unaldevelopment/8-Channel-Wireless-EEG/eeg.kicad_pcb

## KiCad design eeg.kicad_pcb (2026-10-16)

Schematic: eeg.sch, EEG HEADSET

Parts:
C1: 1nF; C_0603_1608Metric
C2, C3, C4, C5, C6, C7, C8, C9, C10, C11, C12, C13, C14, C15, C16, C17, C18, C19: 4.7nF; C_0603_1608Metric
C20, C104, C105, C109, C110, C114, C115, C119, C120: 10uF; C_0603_1608Metric
C40, C48, C49, C50, C54, C58, C63, C66, C76, C77, C79, C106, C107, C108, C111, C112: 1uF; C_0603_1608Metric
C41, C52, C53, C56, C57, C59, C61, C64, C68, C70, C71, C72, C73, C74, C75, C78: 0.1uF; C_0603_1608Metric
C42: 4.7uF; C_0603_1608Metric
C51: 1.5nF; C_0805_2012Metric
C62, C69: 100uF; RESC3216X65N
C65: 10uF; RESC3216X65N
C67: 4.7uF; RESC3216X65N
C80, C81: 9pF; C_0603_1608Metric
C83: 0.1uF; CP_EIA-1608-08_AVX-J_Pad1.25x1.05mm_HandSolder
C100, C102: 1uF_X5R_0603; CAPC1608X94N
C101, C103: 100nF; CAPC1005X55N
C113, C116, C118: 2.2uF; C_0603_1608Metric
C117: 0.01uF; C_0603_1608Metric
D1, D2, D3, D4, D7: LED; LED_0603_1608Metric
HC7361: 2.048mhz; OSCCC500X320X150N
J1, J2, J3, J4: Conn_01x05_Male; PinHeader_1x05_P2.54mm_Vertical
J5: Conn_01x10; PinHeader_1x10_P1.27mm_Vertical
J6, J7: Conn_01x10_Male; PinSocket_1x10_P2.54mm_Vertical
J10: USB_B_Mini; USB_Micro-B_Molex_47346-0001
L1, L2, L4, L5: 3.3uH; INDC2012X87N
R1, R3, R5, R7, R9, R11, R13, R15, R17, R19: 4.99k; RESC1608X55N
R2, R4, R6, R8, R10, R12, R14, R16, R18: 4.99K; RESC1608X55N
R20, R21, R22, R32: 270; R_0603_1608Metric
R23: 10R
R24, R25: 4.7K
R26: 10K; R_0603_1608Metric
R27: 1M; RESC2012X60N
R28, R29: 10K; RESC1608X55N
R31: 270; R_0805_2012Metric
SW2: SW_DIP_x03; SW_DIP_SPSTx03_Slide_6.7x9.18mm_W6.73mm_P2.54mm_LowProfile_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
SW3: EVQ-Q2K03W
U1: STM32F446RE; LQFP-64_10x10mm_P0.5mm
U2: ADS1299-8; TQFP-64_10x10mm_P0.5mm
U3: LD39050PU33R; SON95P300X300X100-7N; DIGI-KEY_PART_NUMBER 497-8716-1-ND
U4: TPS60403DBVT; SOT95P280X145-5N
U5: TPS73225DBVT; SOT95P280X145-5N
U6: TPS72325DBVT; SOT95P280X145-5N
U12: RN4678-V_RM100; RM100
Y1: 16.00Mhz; Crystal_SMD_5032-4Pin_5.0x3.2mm

Connections:
+2V5: C40.1, C41.1, C49.1, C53.1, C115.1, J2.1, L5.2, U2.19 (AVDD), U2.21 (AVDD), U2.22 (AVDD), U2.54 (AVDD1), U2.56 (AVDD), U2.59 (AVDD)
+3V3: C20.2, C56.2, C57.1, C58.1, C59.2, C61.1, C64.2, C67.1, C71.1, C72.1, C73.1, C74.1, C75.2, C76.1, C77.1, C78.1, C79.1, C102.1, C103.1, HC7361.1 (EN), HC7361.4 (Vdd), J2.3, J4.1, J4.2, R28.2, R29.2, U1.1 (VBAT), U1.13 (VDDA/VREF+), U1.19 (VDD), U1.32 (VDD), U1.48 (VDD), U1.64 (VDD), U2.48 (DVDD), U2.50 (DVDD), U3.4 (VOUT), U12.4 (BAT_IN), U12.5 (SW_BTN)
+5V: C100.1, C101.1, C104.1, J3.1, J3.2, J3.3, J10.1 (VBUS), L1.1, U3.1 (EN), U3.6 (VIN)
-2V5: C48.2, C50.2, C52.2, C54.2, C62.2, C63.2, C65.2, C66.2, C68.1, C69.2, C70.2, C120.1, J2.2, L4.2, U2.20 (AVSS), U2.23 (AVSS), U2.25 (VREFN), U2.32 (AVSS), U2.53 (AVSS1), U2.57 (AVSS), U2.58 (AVSS)
-5V: C110.1, C116.1, L2.2, U6.2 (IN), U6.3 (EN)
/BIASIN: C1.1, C51.2, R1.2, R27.2, U2.62 (BIASIN), U2.63 (BIASOUT)
/BIASINV: C51.1, J7.1, R27.1, U2.61 (BIASINV)
/CBIAS: J7.2, R1.1
/CIN1N: J6.7, R16.1
/CIN1P: J6.8, R17.1
/CIN2N: J6.5, R14.1
/CIN2P: J6.6, R15.1
/CIN3N: J6.3, R12.1
/CIN3P: J6.4, R13.1
/CIN4N: J6.1, R10.1
/CIN4P: J6.2, R11.1
/CIN5N: J7.9, R8.1
/CIN5P: J7.10, R9.1
/CIN6N: J7.7, R6.1
/CIN6P: J7.8, R7.1
/CIN7N: J7.5, R4.1
/CIN7P: J7.6, R5.1
/CIN8N: J7.3, R2.1
/CIN8P: J7.4, R3.1
/CLK: HC7361.3 (OUT), J5.3, U2.37 (CLK)
/CSRB1: J6.9, R18.1
/CSRB2: J6.10, R19.1
/IN1N: C16.2, R16.2, U2.15 (IN1N)
/IN1P: C17.2, R17.2, U2.16 (IN1P)
/IN2N: C14.2, R14.2, U2.13 (IN2N)
/IN2P: C15.2, R15.2, U2.14 (IN2P)
/IN3N: C12.2, R12.2, U2.11 (IN3N)
/IN3P: C13.2, R13.2, U2.12 (IN3P)
/IN4N: C10.2, R10.2, U2.9 (IN4N)
/IN4P: C11.2, R11.2, U2.10 (IN4P)
/IN5N: C8.1, R8.2, U2.7 (IN5N)
/IN5P: C9.2, R9.2, U2.8 (IN5P)
/IN6N: C6.1, R6.2, U2.5 (IN6N)
/IN6P: C7.2, R7.2, U2.6 (IN6P)
/IN7N: C4.1, R4.2, U2.3 (IN7N)
/IN7P: C5.2, R5.2, U2.4 (IN7P)
/IN8N: C2.1, R2.2, U2.1 (IN8N)
/IN8P: C3.2, R3.2, U2.2 (IN8P)
/RN46CTS: U1.15 (PA1), U12.15 (P1_7/CTS)
/RN46RTS: U1.14 (PA0), U12.17 (P0_0/RTS)
/SRB1: C18.2, R18.2, U2.17 (SRB1)
/SRB2: C19.2, R19.2, U2.18 (SRB2)
/USART6_RX: U1.38 (PC7), U12.23 (TXD)
/USART6_TX: U1.37 (PC6), U12.22 (RXD)
/VCAP3: C50.1, C70.1, U2.55 (VCAP3)
CS: J5.7, U1.50 (PA15), U2.39 (CS)
DRDY: J5.9, U1.51 (PC10), U2.47 (DRDY)
MISO: J5.6, U1.56 (PB4), U2.43 (DOUT)
MOSI: J5.5, U1.57 (PB5), U2.34 (DIN)
unnamed: C42.1, U1.30 (VCAP_1)
unnamed: C54.1, U2.30 (VCAP2)
unnamed: C66.1, U2.26 (VCAP4)
unnamed: C69.1, U2.28 (VCAP1)
unnamed: C80.1, U1.6 (PH1-OSC_OUT), Y1.1
unnamed: C83.1, SW3.2, SW3.4, U1.7 (NRST)
unnamed: C105.1, C106.1, C111.1, L1.2, U4.2 (IN), U5.1 (IN), U5.3 (EN)
unnamed: C107.1, U4.5 (CFLY+)
unnamed: C107.2, U4.3 (CFLY-)
unnamed: C108.1, C109.1, L2.1, U4.1 (OUT)
unnamed: C112.1, U5.4 (NR)
unnamed: C113.1, C114.1, L5.1, U5.5 (OUT)
unnamed: C117.1, U6.4 (NR)
unnamed: C118.1, C119.1, L4.1, U6.5 (OUT)
unnamed: D1.2 (A), R32.2
unnamed: D2.1 (K), R20.1
unnamed: D2.2 (A), U1.27 (PB1)
unnamed: D3.1 (K), R21.1
unnamed: D3.2 (A), U1.26 (PB0)
unnamed: D4.1 (K), R22.1
unnamed: D4.2 (A), U1.25 (PC5)
unnamed: D7.1 (K), U12.30 (LED)
unnamed: D7.2 (A), R31.1
unnamed: R26.2, U1.60 (BOOT0)
unnamed: R23.1, R31.2, U12.6 (LDO33_O), U12.7 (VDD_IO), U12.9 (WAKEUP)
unnamed: R32.1, U2.42 (GPIO1)
PWDN: J5.1, R28.1, U1.61 (PB8), U2.35 (PWDN)
RESET: J5.2, R29.1, U1.59 (PB7), U2.36 (RESET)
SCLK: J5.8, U1.55 (PB3), U2.40 (SCLK)
START: J5.4, U1.58 (PB6), U2.38 (START)
SWCLK: J4.4, U1.49 (PA14)
SWDIO: J4.3, U1.46 (PA13)
VREFP: C65.1, C68.2, J1.3, J1.4, J1.5, U2.24 (VREFP)

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
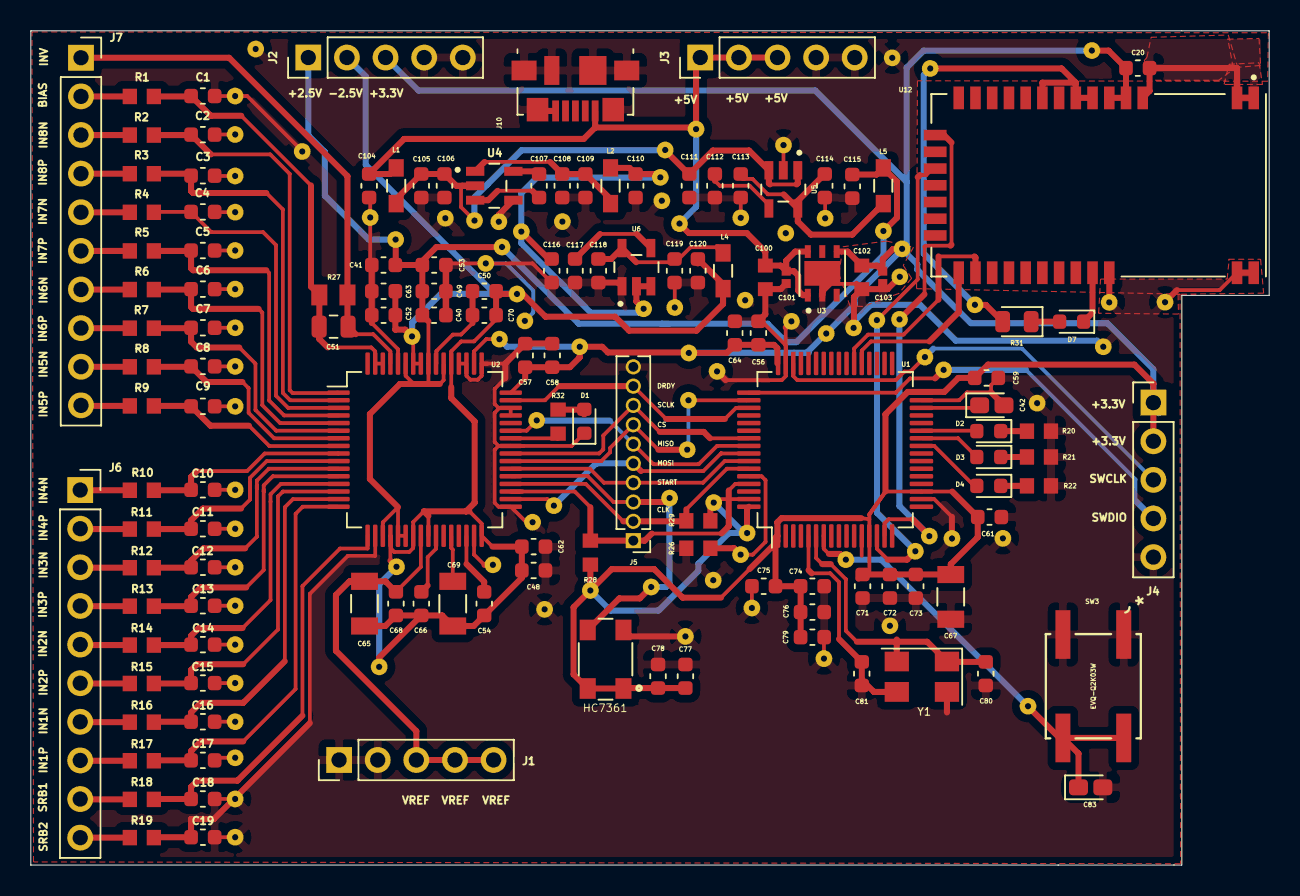
[picture p2: board eeg.kicad_pcb from above]

Board: 2 copper layers, 81.4 x 54.9 mm, 132 parts (0 on the bottom side), 89 nets.
